burgrp/hw-bms-48v/README.md

# hw-bms-48v
48V/200A battery monitoring system
