burgrp/hw-bms-48v/board/HSTS016L.jpg

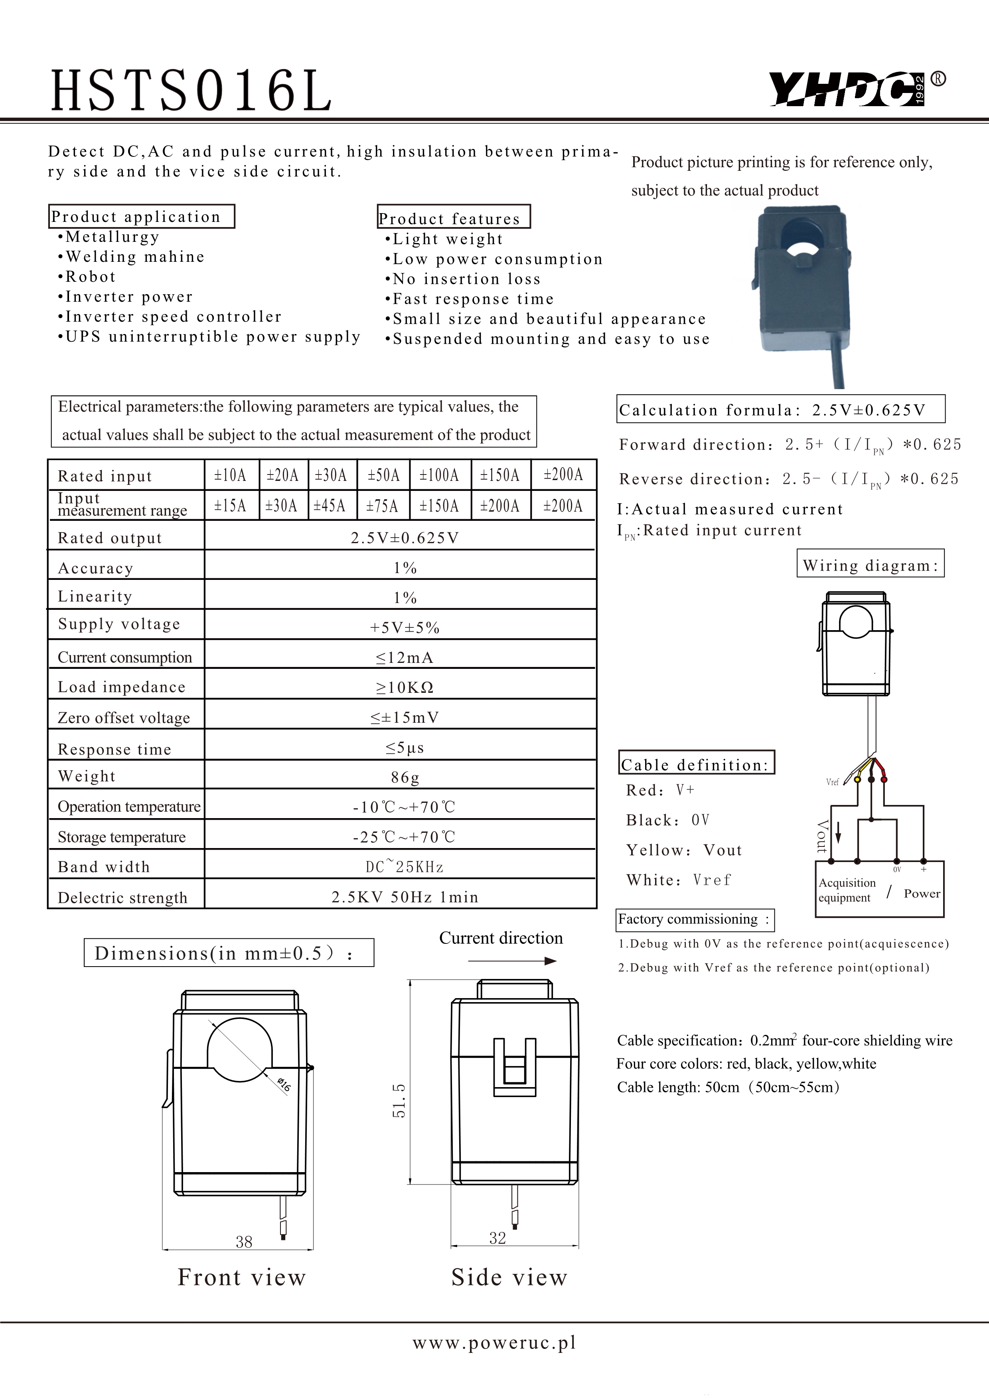
board/HSTS016L.jpg
