burgrp/hw-bms-48v/board/L_12x12mm_H8mm.step

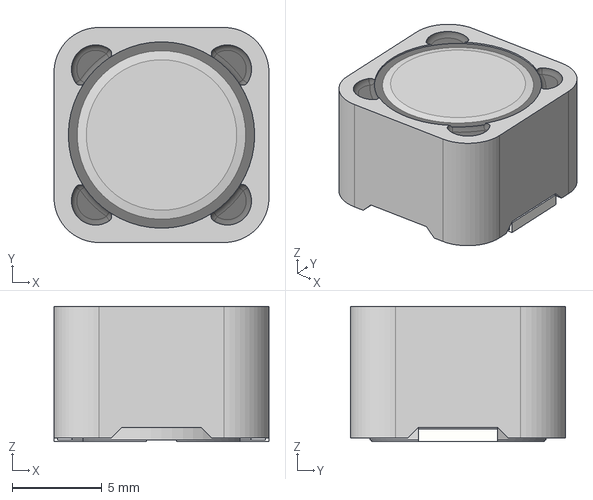
[picture p2: CAD file, 2023-02-26]
board/L_12x12mm_H8mm.step
12.0 x 12.0 x 7.56 mm
