burgrp/hw-bms-48v/board/hw-bms-48v.kicad_pcb

## KiCad design board/hw-bms-48v.kicad_pcb (2023-04-15)

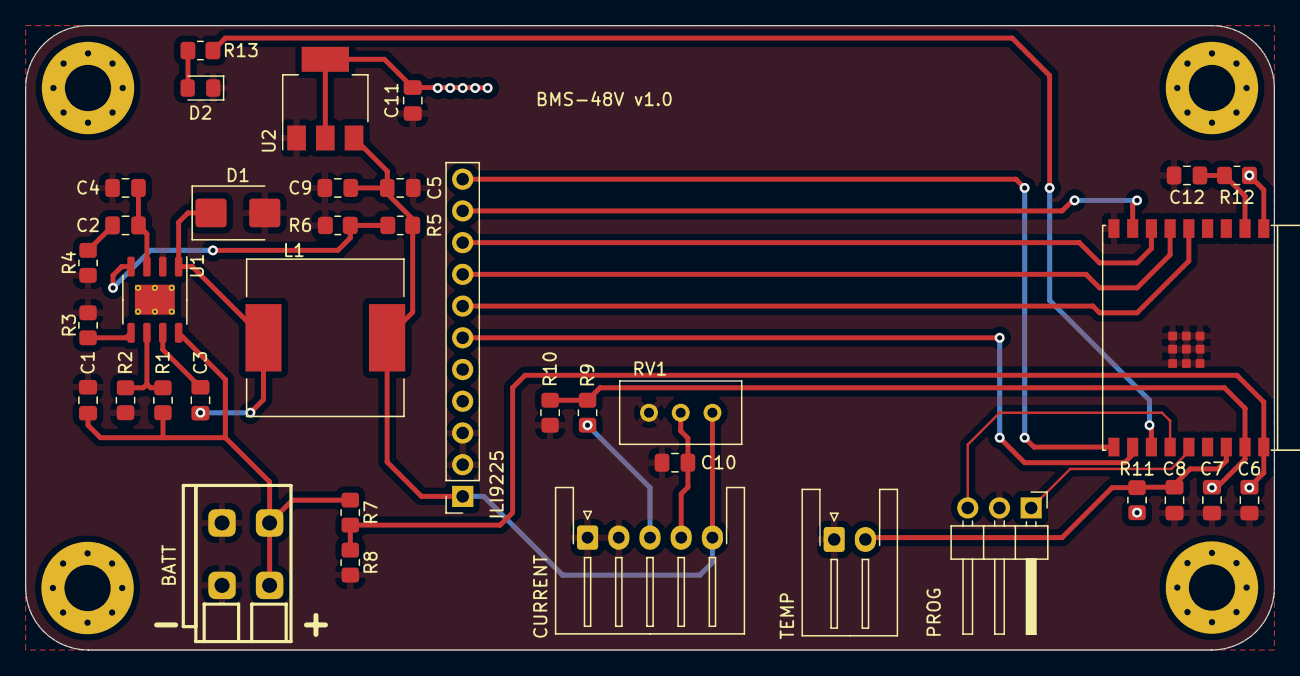
[picture p3: board hw-bms-48v.kicad_pcb from above]

Board: 2 copper layers, 100.0 x 50.0 mm, 41 parts (0 on the bottom side), 27 nets.

Parts:
C1: 10u/100V; C_0805_2012Metric_Pad1.18x1.45mm_HandSolder
C2: 6n8; C_0805_2012Metric_Pad1.18x1.45mm_HandSolder
C3: 100n; C_0805_2012Metric_Pad1.18x1.45mm_HandSolder
C4: ???; C_0805_2012Metric_Pad1.18x1.45mm_HandSolder
C5, C9, C11: 47u; C_0805_2012Metric_Pad1.18x1.45mm_HandSolder
C6, C7, C8, C10, C12: 1u; C_0805_2012Metric_Pad1.18x1.45mm_HandSolder
D1: SK22; D_SMB
D2: LED; LED_0805_2012Metric_Pad1.15x1.40mm_HandSolder
H1, H2, H3, H4: MountingHole; MountingHole_3.7mm_Pad_Via
J1: BATT; DG235-3.81-02P
J2: PROG; PinHeader_1x03_P2.54mm_Horizontal
J3: CURRENT; JST_XH_S5B-XH-A-1_1x05_P2.50mm_Horizontal
J4: TEMP; JST_XH_S2B-XH-A-1_1x02_P2.50mm_Horizontal
J5: ILI9225; PinSocket_1x11_P2.54mm_Vertical
L1: 33uH; L_12x12mm_H6mm
R1, R7, R10: 100k; R_0805_2012Metric_Pad1.20x1.40mm_HandSolder
R2: 20k; R_0805_2012Metric_Pad1.20x1.40mm_HandSolder
R3: 47k; R_0805_2012Metric_Pad1.20x1.40mm_HandSolder
R4, R12: 10k; R_0805_2012Metric_Pad1.20x1.40mm_HandSolder
R5: 3k; R_0805_2012Metric_Pad1.20x1.40mm_HandSolder
R6: 750R; R_0805_2012Metric_Pad1.20x1.40mm_HandSolder
R8: 3k9; R_0805_2012Metric_Pad1.20x1.40mm_HandSolder
R9, R11: 27k; R_0805_2012Metric_Pad1.20x1.40mm_HandSolder
R13: 270R; R_0805_2012Metric_Pad1.20x1.40mm_HandSolder
RV1: 10k; Potentiometer_Bourns_3296W_Vertical
U1: BD9G341EFJ; HTSOP-8-1EP_3.9x4.9mm_P1.27mm_EP2.4x3.2mm_ThermalVias
U2: LM1117MP-3.3; SOT-223-3_TabPin2
U3: ESP32-C3-WROOM-02

Connections:
+3V3: C11.2, R11.1, R12.1, U2.2 (VO), U3.1 (3V3)
+5V: C5.2, C9.2, J3.5, J5.1, L1.2, R5.1, RV1.3, U2.3 (VI)
+BATT: C1.2, J1.2, R1.1, R7.1, U1.8 (VCC)
/LCD_BL: J5.6, U3.11 (GPIO20/U0RXD)
/LCD_RS: J5.9, U3.7 (GPIO8)
/LCD_RST: J5.10, U3.8 (GPIO9)
/LCD_SCK: J5.7, U3.5 (GPIO6)
/LCD_SDI: J5.8, U3.6 (GPIO7)
/LCD_SS: J5.11, U3.10 (GPIO10)
/LED: R13.1, U3.12 (GPIO21/U0TXD)
/USB_D+: J2.1, U3.14 (GPIO19/USB_D+)
/USB_D-: J2.3, U3.13 (GPIO18/USB_D-)
GND: C1.1, C4.1, C5.1, C6.1, C7.1, C8.1, C9.1, C10.1, C11.1, C12.1, D1.2 (A), D2.1 (K), J1.1, J2.2, J3.1, J3.2, J4.1, J5.2, J5.3, R2.2, R3.2, R4.2, R6.2, R8.2, R10.2, RV1.1, U1.2 (GND), U2.1 (GND), U3.9 (GND), U3.19 (GND)
unnamed: C2.1, R4.1
unnamed: C3.1, D1.1 (K), L1.1, U1.1 (LX)
unnamed: D2.2 (A), R13.2
unnamed: J3.3, R9.1
unnamed: C10.2, J3.4, RV1.2
unnamed: C8.2, J4.2, R11.2, U3.16 (GPIO2/ADC1_CH2)
unnamed: C3.2, U1.7 (BST)
unnamed: R1.2, R2.1, U1.6 (EN)
unnamed: R5.2, R6.1, U1.4 (FB)
unnamed: R3.1, U1.5 (RT)
unnamed: C2.2, C4.2, U1.3 (VC)
unnamed: C12.2, R12.2, U3.2 (EN/CHIP_PU)
unnamed: C6.2, R7.2, R8.1, U3.18 (GPIO0/ADC1_CH0/XTAL_32K_P)
unnamed: C7.2, R9.2, R10.1, U3.17 (GPIO1/ADC1_CH1/XTAL_32K_N)
